RobertFromTX/two_wheeled_balancing_robot/assets/images/IMG_3529.JPG

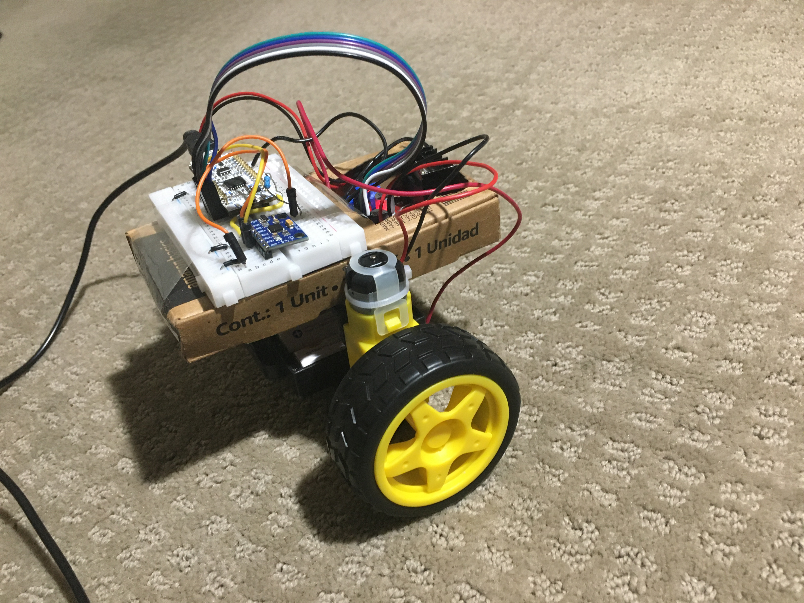
assets/images/IMG_3529.JPG
