RobertFromTX/two_wheeled_balancing_robot/assets/images/IMG_3532.JPG

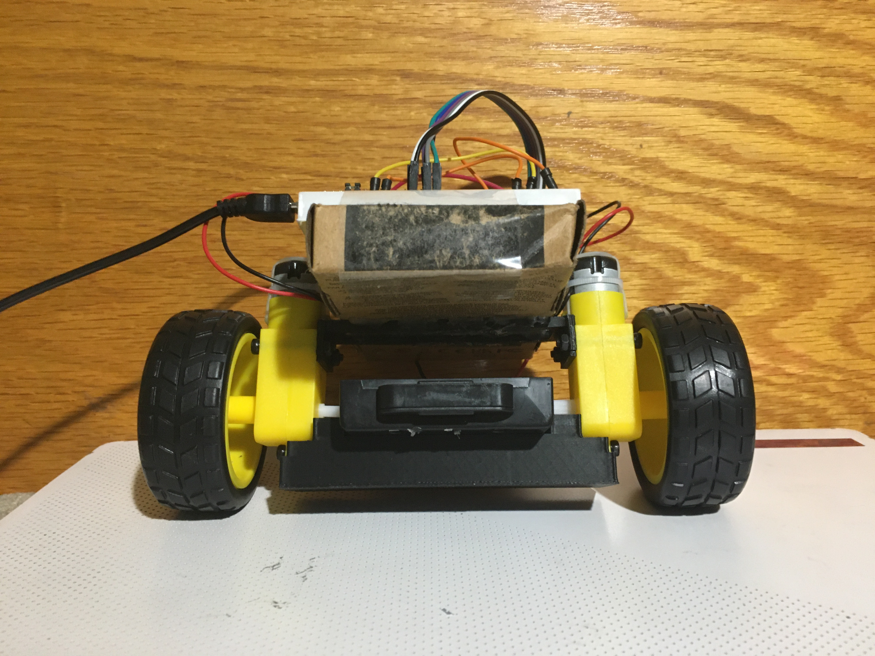
assets/images/IMG_3532.JPG
