RobertFromTX/two_wheeled_balancing_robot/two_wheel_balance/two_wheel_balance.ioc

Mcu.UserName=STM32F303K8Tx
PA13.Signal=SYS_JTMS-SWDIO
PA14.Signal=SYS_JTCK-SWCLK
PA8.Signal=S_TIM1_CH1
PA9.Signal=GPIO_Output
PB3.Signal=GPXTI3
PB4.Signal=GPIO_Output
PB5.Signal=GPIO_Output
PB6.Signal=I2C1_SCL
PB7.Signal=I2C1_SDA
