RobertFromTX/two_wheeled_balancing_robot/(commit log)

2025-06-02 able to get sensor data now
2025-06-02 successfully extracting data from accelerometer
2025-06-09 created two wheel balance project
2025-06-10 able to convert accelerometer data to pitch and roll but no calibration code yet
2025-06-13 decent kalman filter output
2025-06-13 filter seems slow
2025-06-18 point before adding PID
2025-06-18 PID rough implementation done
2025-06-23 progress on 130 motors, found these motors are not feasible for this project
2025-07-15 pid configurations added
2025-08-11 Added BOM to README
2025-08-12 added Housing to README
