RobertFromTX/two_wheeled_balancing_robot/(notices)

Notices in the files:
two_wheel_balance/Core/Src/main.c:
Copyright (c) 2025 STMicroelectronics.
All rights reserved.
This software is licensed under terms that can be found in the LICENSE file
