RobertFromTX/two_wheeled_balancing_robot/assets/images/IMG_3530.JPG

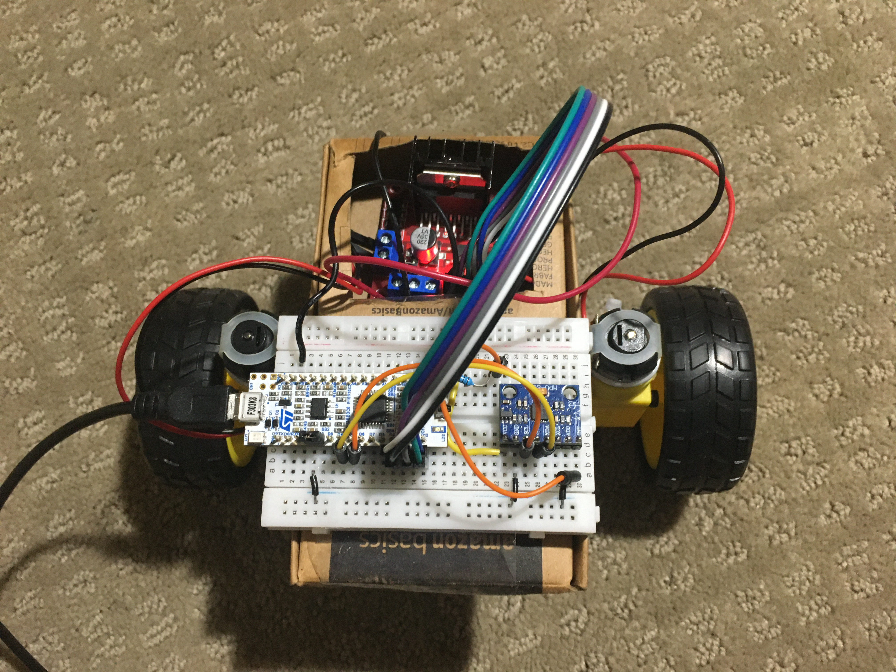
assets/images/IMG_3530.JPG
